Roman3349/maturitni-prace/README.md

# maturitni-prace
Repozitář pro maturitní práci z informatiky
