Roman3349/maturitni-prace/doc/img/blokove-schema/komunikace.pdf

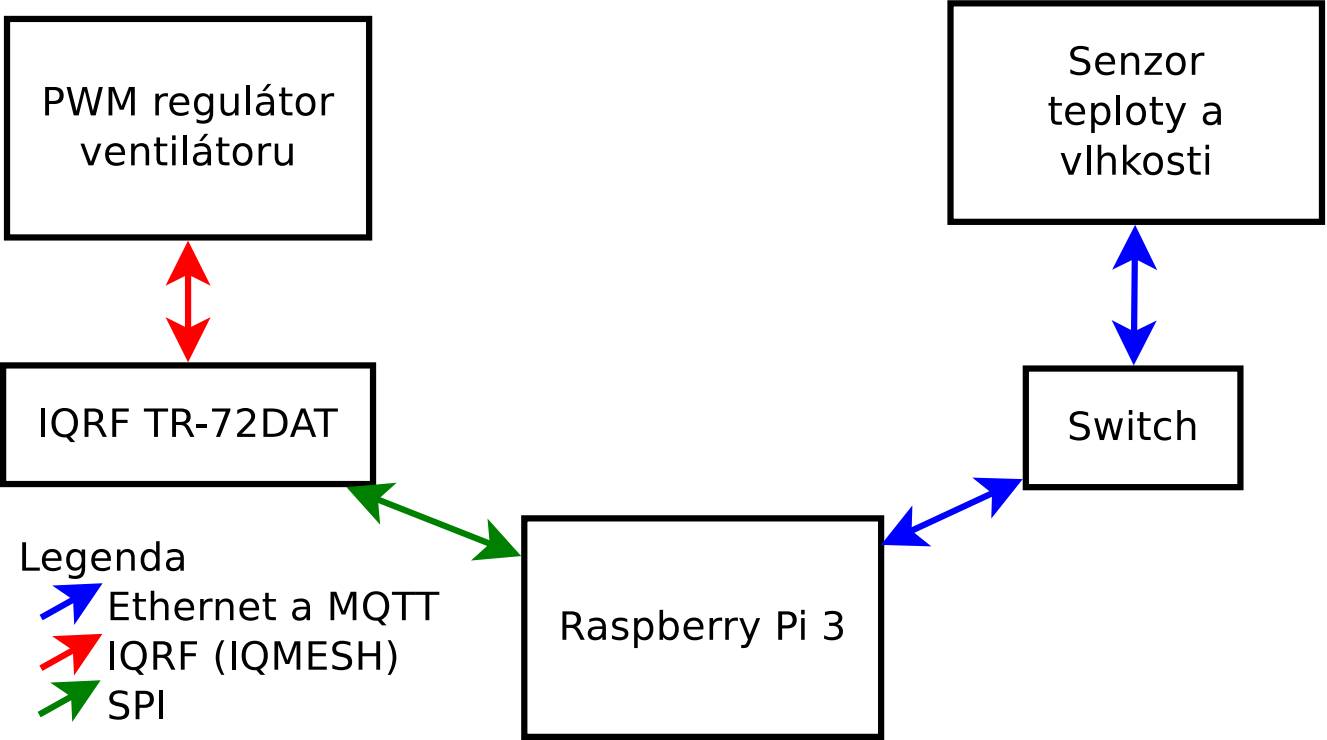
[picture p21: page 1]
