Roman3349/maturitni-prace/doc/img/blokove-schema/senzor.pdf

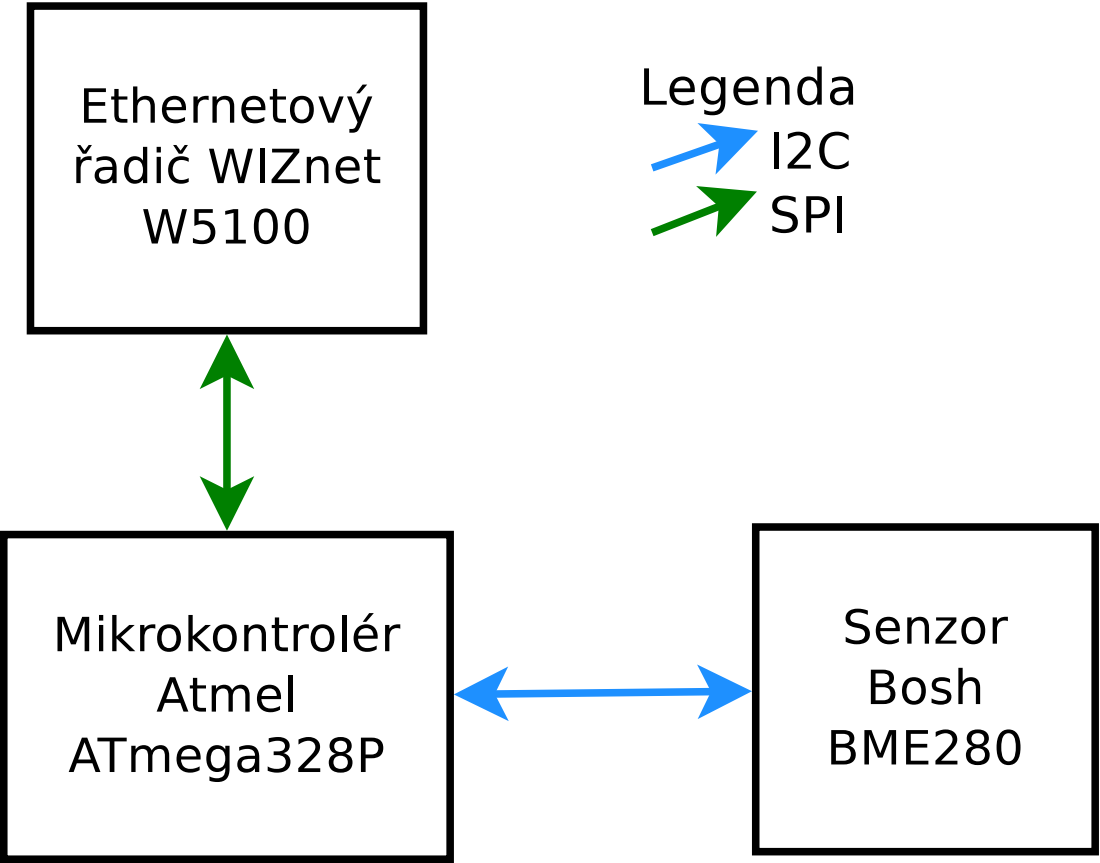
[picture p22: page 1]
