Roman3349/maturitni-prace/doc/img/kicad/fan-regulator-board.pdf

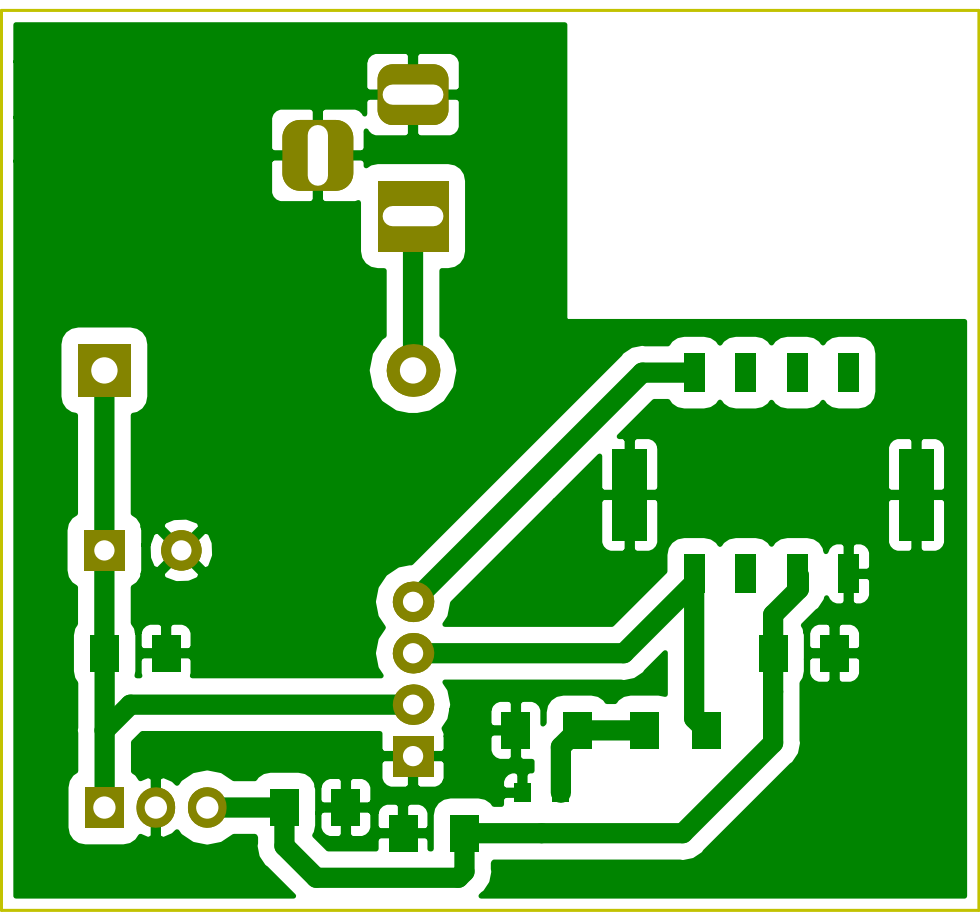
[picture p23: page 1]
