Roman3349/maturitni-prace/doc/img/kicad/sensor-board.pdf

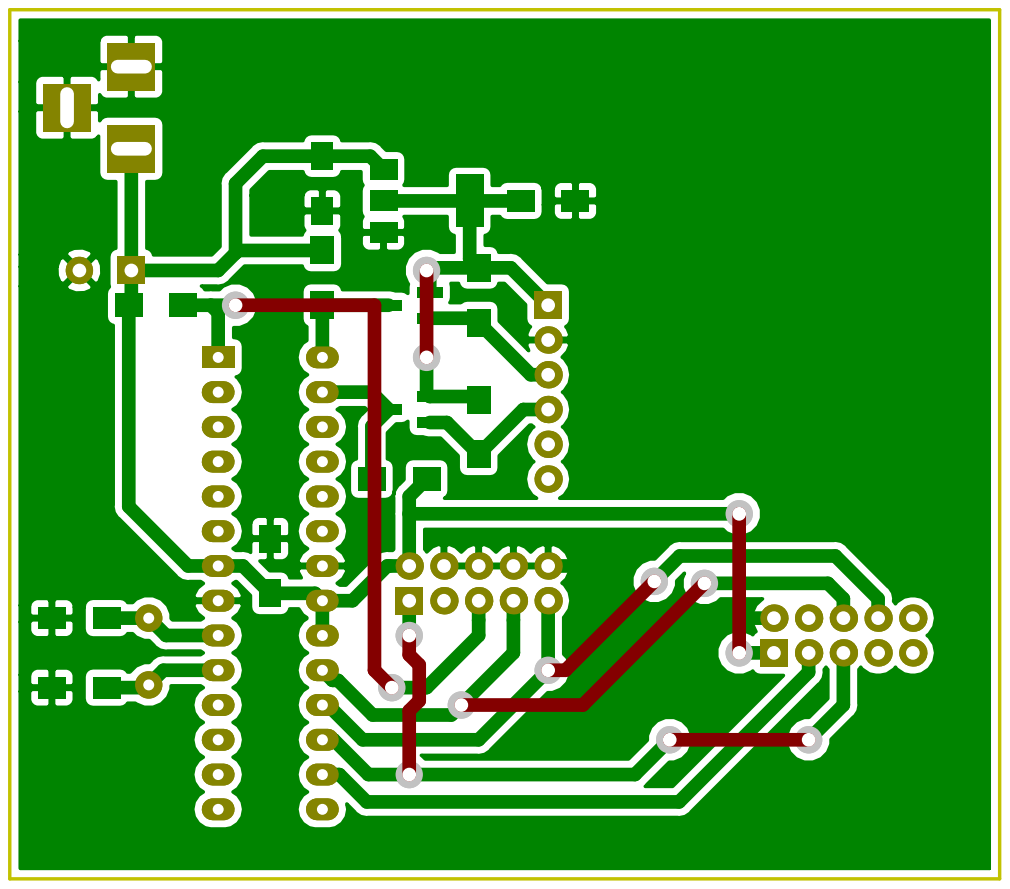
[picture p24: page 1]
