Roman3349/maturitni-prace/kicad/ethernet-sensor/ethernet-sensor.kicad_pcb

## KiCad design kicad/ethernet-sensor/ethernet-sensor.kicad_pcb (2018-04-26)

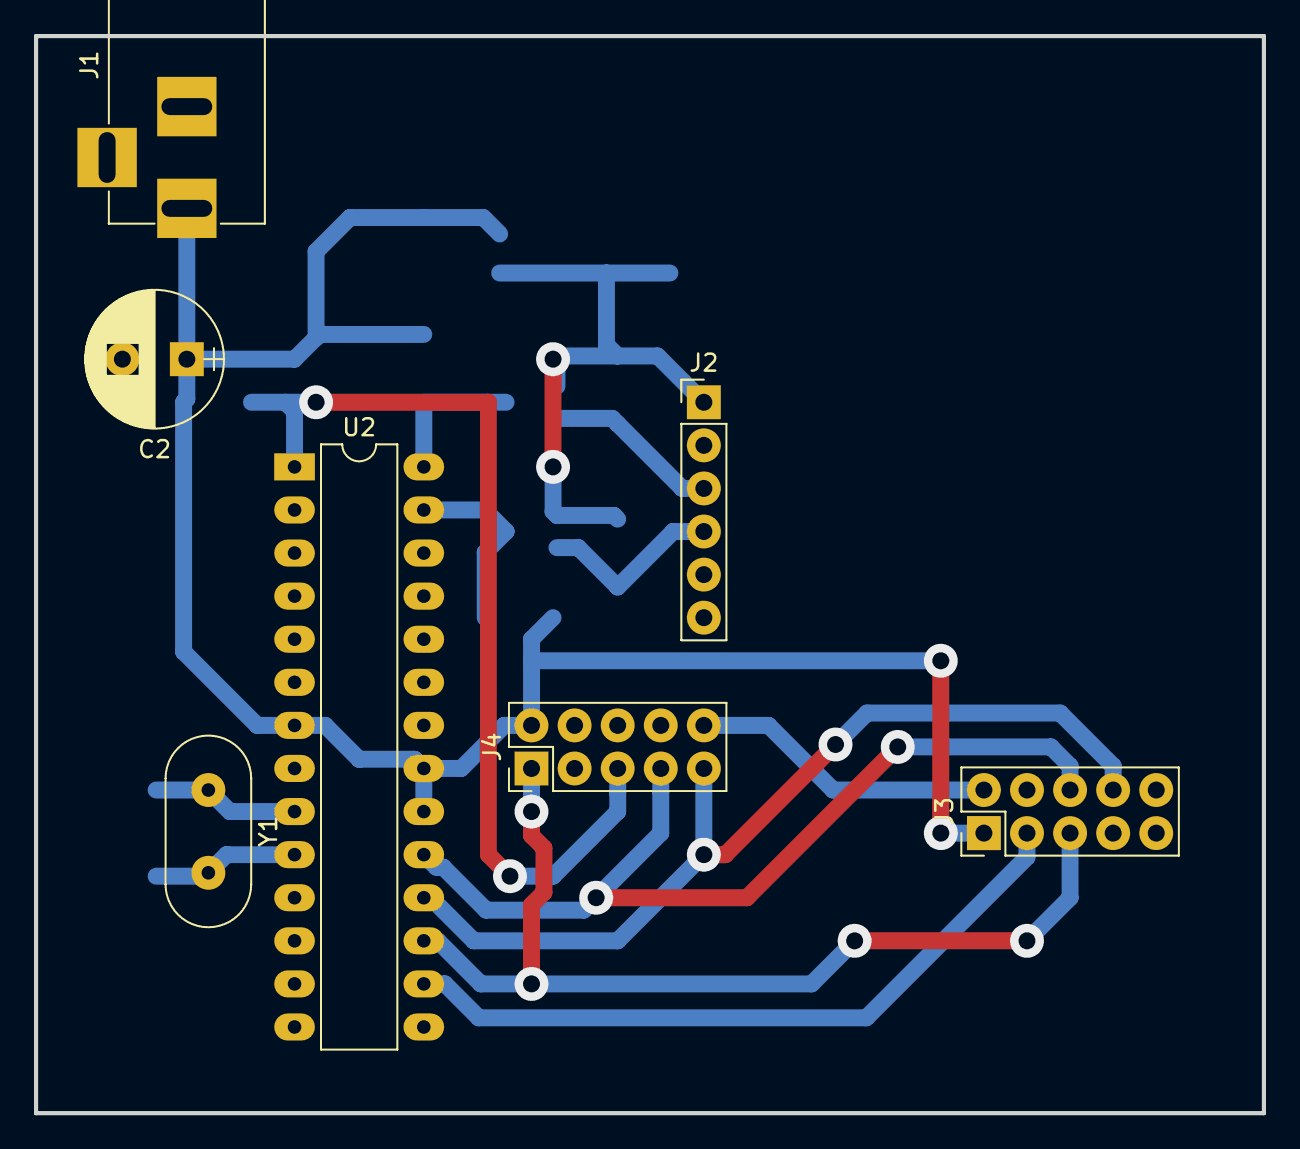
[picture p25: board ethernet-sensor.kicad_pcb from above]

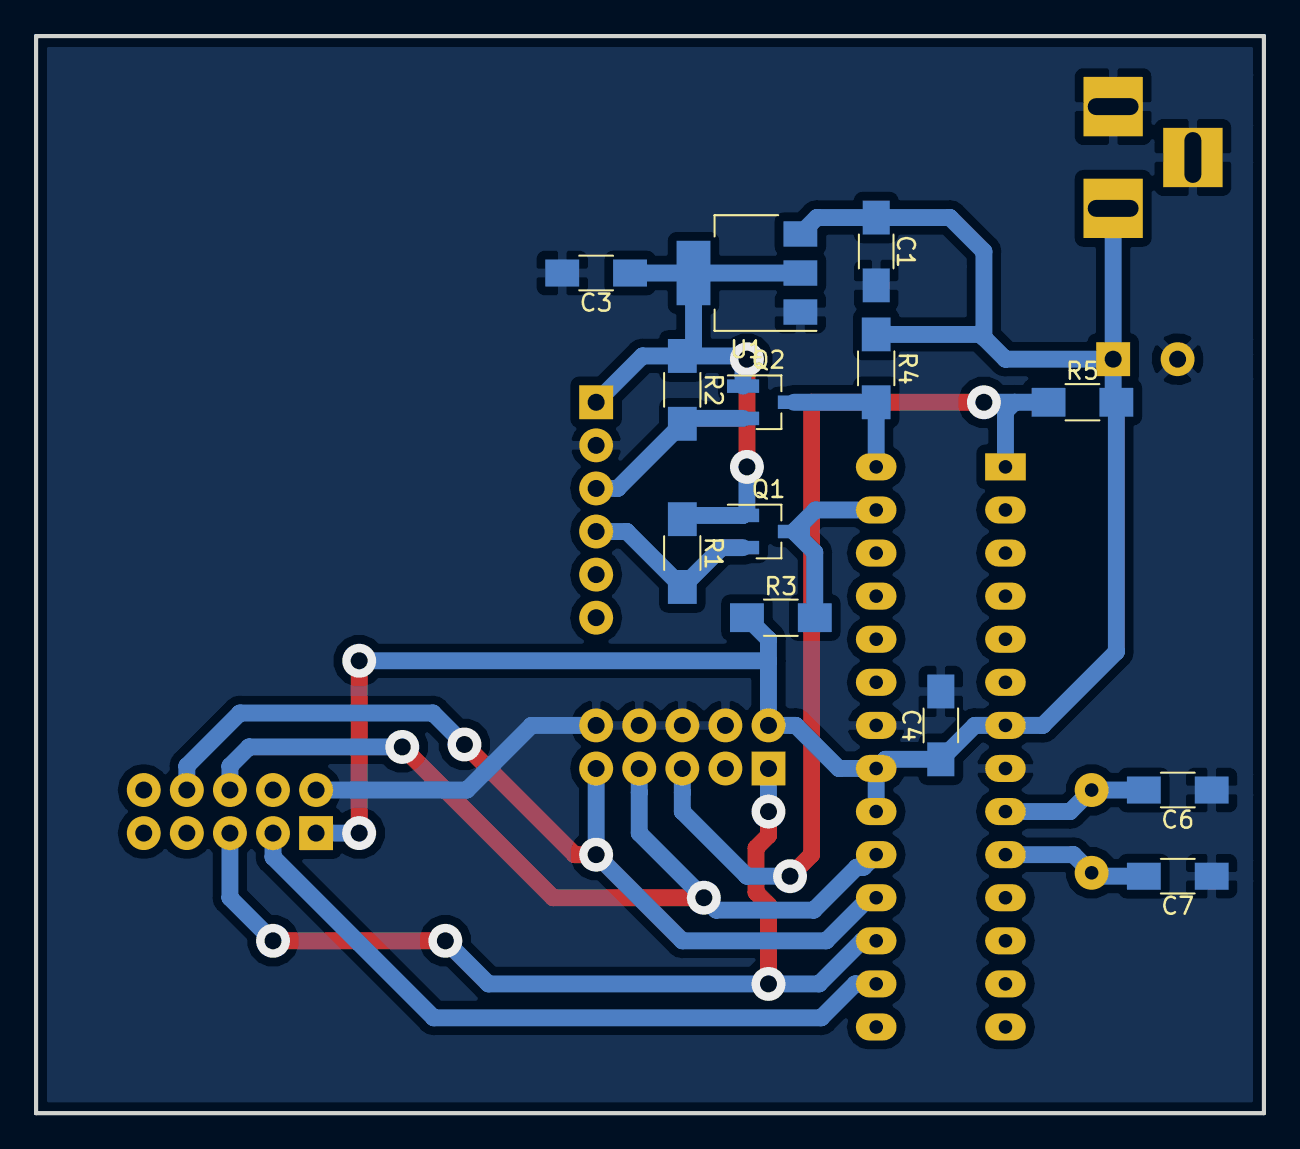
[picture p26: board ethernet-sensor.kicad_pcb from below]

Board: 2 copper layers, 72.4 x 63.5 mm, 20 parts (13 on the bottom side), 14 nets.

Parts:
C1, C3, C4: 100n; C_1206_HandSoldering
C2: 470uF; CP_Radial_D8.0mm_P3.80mm
C6, C7: 18p; C_1206_HandSoldering
J1: Barrel_Jack; BARREL_JACK
J2: Conn_BME280; Pin_Header_Straight_1x06_Pitch2.54mm
J3: Conn_W5100; Pin_Header_Straight_2x05_Pitch2.54mm
J4: AVR-ISP-10; Pin_Header_Straight_2x05_Pitch2.54mm
Q1, Q2: BSS138; SOT-23_Handsoldering
R1, R2, R3, R4, R5: 10k; R_1206_HandSoldering
U1: NCP1117-3.3_SOT223; SOT-223-3_TabPin2
U2: ATmega328P-PU; DIP-28_W7.62mm_LongPads
Y1: 16MHz; Crystal_HC49-U_Vertical

Connections:
+3V3: C3.1, J2.1, Q1.1, Q2.1, R1.1, R2.1, U1.2
+5V: C1.1, C2.1, C4.1, J1.1, J3.1, J4.2, R3.1, R4.1, R5.2, U1.3, U2.7, U2.20, U2.21
GND: C1.2, C2.2, C3.2, C4.2, C6.1, C7.1, J1.2, J1.3, J2.2, J3.2, J4.4, J4.6, J4.8, J4.10, U1.1, U2.8, U2.22
MISO: J3.8, J4.9, U2.18
MOSI: J3.5, J4.1, U2.17
unnamed: C6.2, U2.9, Y1.1
unnamed: C7.2, U2.10, Y1.2
RESET: J4.5, R5.1, U2.1
SCK: J3.6, J4.7, U2.19
SCL_Hi: Q2.3, R4.2, U2.28
SCL_Lo: J2.3, Q2.2, R2.2
SDA_Hi: Q1.3, R3.2, U2.27
SDA_Lo: J2.4, Q1.2, R1.2
SS: J3.3, U2.16
