Roman3349/maturitni-prace/kicad/fan-regulator/fan-regulator.kicad_pcb

## KiCad design kicad/fan-regulator/fan-regulator.kicad_pcb (2018-04-26)

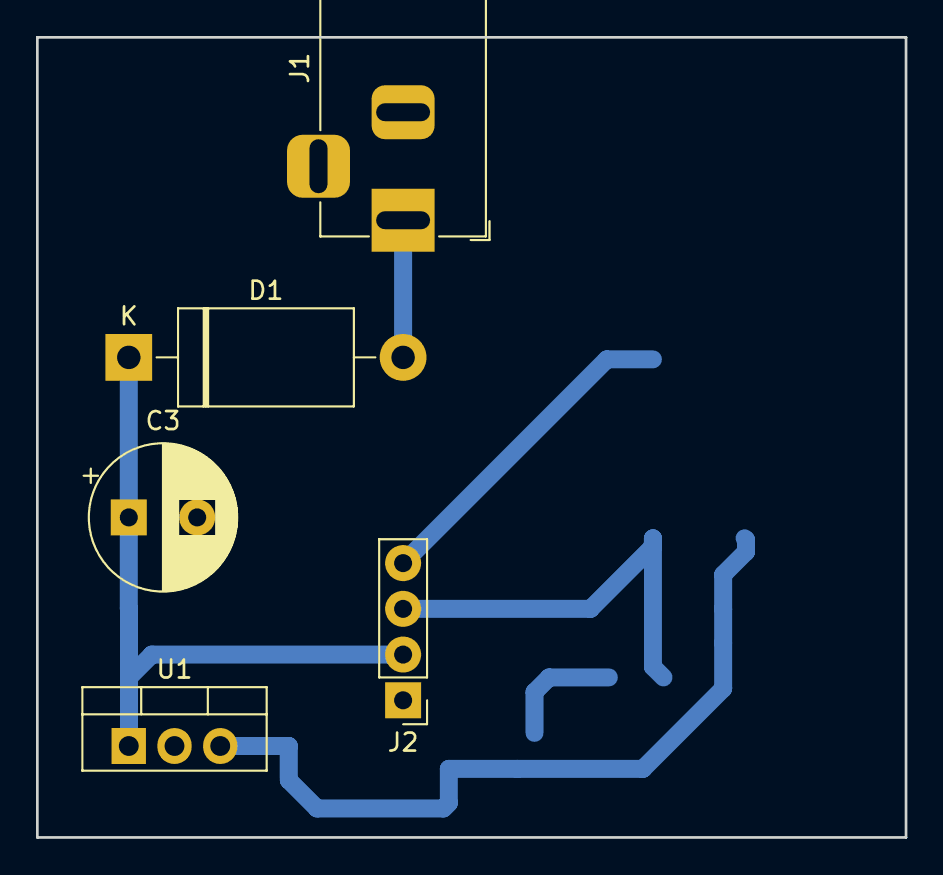
[picture p27: board fan-regulator.kicad_pcb from above]

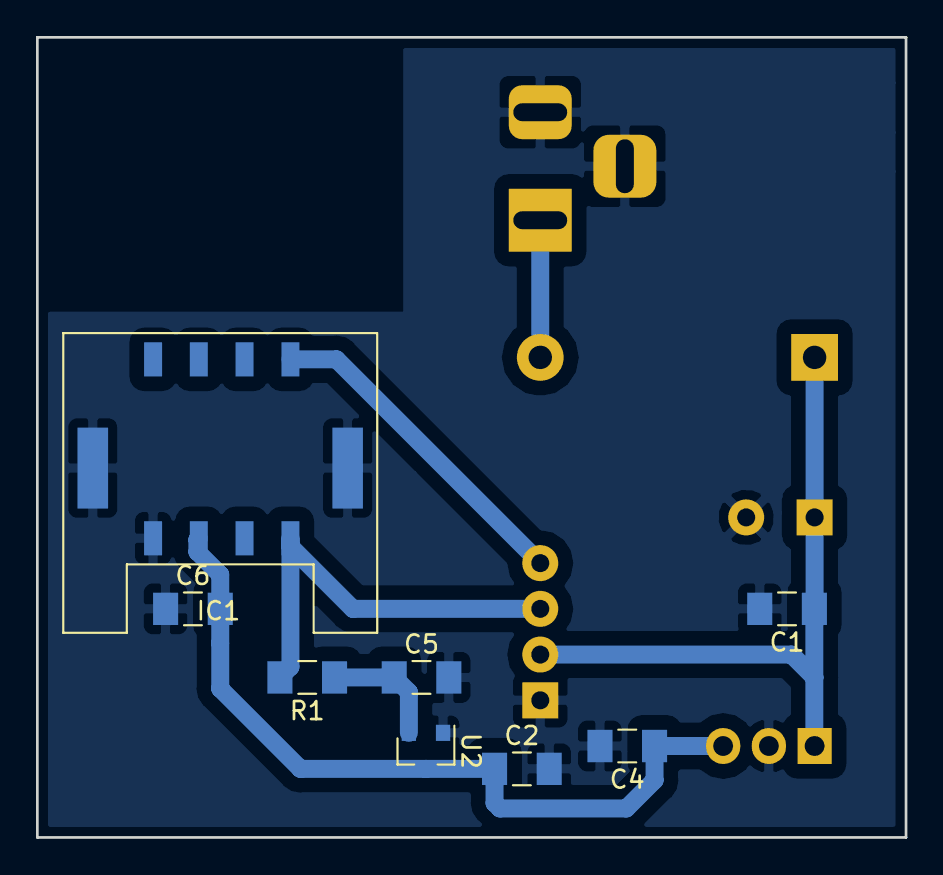
[picture p28: board fan-regulator.kicad_pcb from below]

Board: 2 copper layers, 48.3 x 44.4 mm, 13 parts (8 on the bottom side), 7 nets.

Parts:
C1, C2, C4, C5, C6: 100n; C_1206_3216Metric_Pad1.39x1.80mm_HandSolder
C3: CP; CP_Radial_D8.0mm_P3.80mm
D1: BY550-400; D_DO-201_P15.24mm_Horizontal
IC1: TR-72D; IQRF_TRx2DA_KON-SIM-01
J1: Barrel_Jack; BarrelJack_Horizontal
J2: Conn_01x04_Male; PinHeader_1x04_P2.54mm_Vertical
R1: 10k; R_1206_3216Metric_Pad1.39x1.80mm_HandSolder
U1: LM7805_TO220; TO-220-3_Vertical
U2: MCP1700-3002E_SOT23; SOT-23

Connections:
+3V3: C5.1, R1.1, U2.2
+5V: C2.1, C4.1, C6.2, IC1.3, U1.3, U2.3
+12V: C1.1, C3.1, D1.1, J2.2, U1.1
FAN_PWM: IC1.5, J2.4
FAN_SPEED: IC1.1, J2.3, R1.2
GND: C1.2, C2.2, C3.2, C4.2, C5.2, C6.1, IC1.4, IC1.9, J1.2, J1.3, J2.1, U1.2, U2.1
unnamed: D1.2, J1.1
