Roman3349/maturitni-prace/(commit log)

2018-04-24 Add schemas and PCBs
    [ethernet-sensor.kicad_pcb, ethernet-sensor.sch, fan-regulator.kicad_pcb, fan-regulator.sch]
2018-04-26 Fix bugs in KiCAD EDA's files
    [ethernet-sensor.kicad_pcb, ethernet-sensor.sch, fan-regulator.kicad_pcb]
2018-04-27 Add a source code for the Arduino Ethernet sensor
2018-04-27 Update source code for the Arduino Ethernet sensor
2018-04-28 Add source code for IQRF PWM fan regulator
2018-04-29 Add Node-RED flow
2018-04-29 Update Node-RED flow
2018-04-29 Update software for IQRF PWM fan controller
2018-04-30 Use a P regulator for a temperature regulation
2018-05-17 Fix coding style of Arduino Etherner sensor's source code
    [src.ino]
